cruiten/Voron-Related/README.md

# Voron-Related
Parts and documentation for personal use with my Voron 2.4r2 that are probably not ready for "prime time"...
