cruiten/Voron-Related/CANbus/Documentation/README.md

# CAN Related Installation/Configuration Documentation

Personal notes to document what I did on my Voron 2.4r2...

### Configuration and building

[Step 1. Setting up the SB2040 + CAN bus](./SB2040_CAN/install_configure_can.md)

[Step 2. The umbilical](./Umbilical/README.md)

[Step 3. Setting up the SB2040 with CAN Boot](./SB2040_CAN/install_configure_canboot.md)

&nbsp;

### Quality of life improvements:

[Flash Klipper to the Octopus and the SB2040 in one step](./SB2040_CAN/flash_klipper_script.md)

[CanBoot Deployment Application](./SB2040_CAN/canboot_deployment_application.md)
