cruiten/Voron-Related/CANbus/Umbilical/README.md

# A drive umbilical + Y endstop
## Why?
Created this to help out Discord user @DraHrEg.

I "married" hartk's "A_drive_Umbilical_PG7" and minsekt's "Y-endstop" designs.

I wish this was available when I was doing the umbilical set up for my Voron 2.4r2, because replacing the upper A drive motor plate was quite involved and required more effort than I had planned for.

The PG7 cable gland is a tight fit, so be sure to print this part using the recommend Voron print settings.

P.S. This design probably needs to be updated a bit to allow for better wire management from the switch to the area where the PG7 gland is...

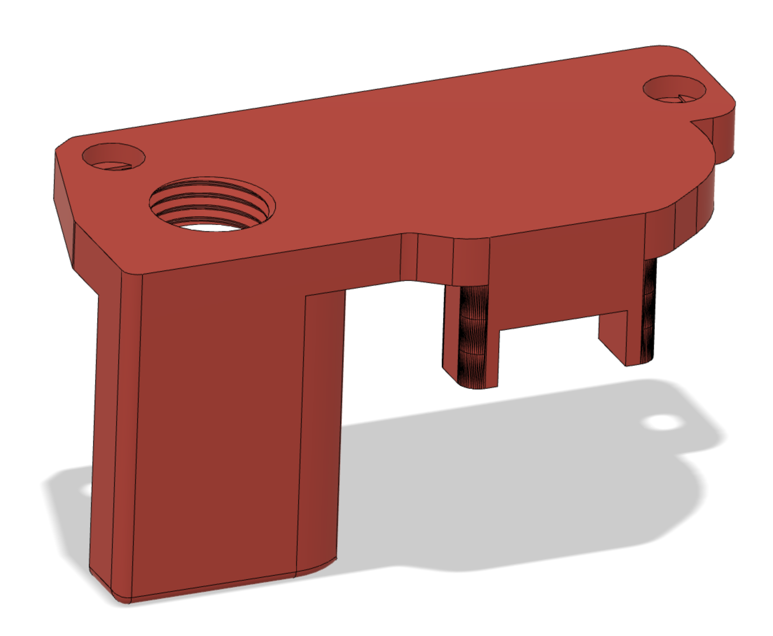
[picture p4: CANbus/Umbilical/Images/image1.png]
Front top view


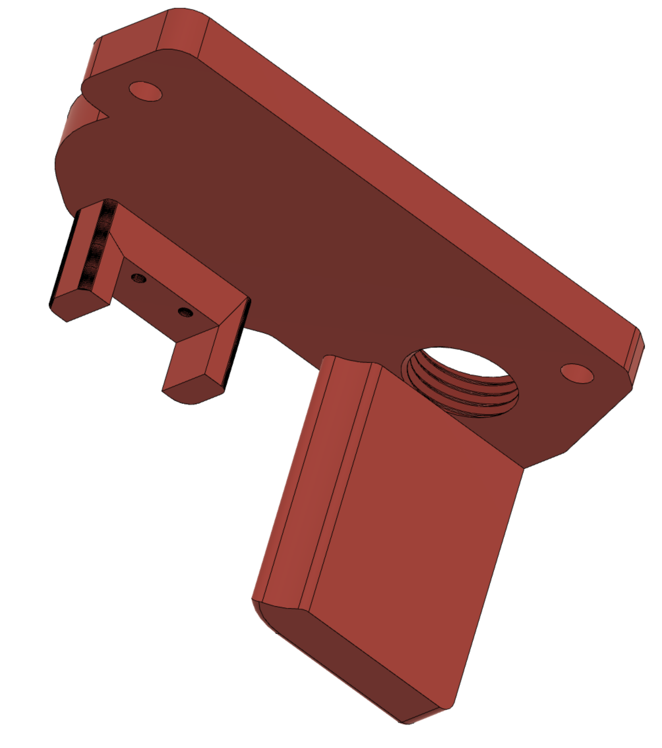
[picture p5: CANbus/Umbilical/Images/image2.png]
Bottom back view


</details>

# Umbilical mount for Clockwork 2 - Skinny Y version
## Why?
Modified hartk's version so that it would not crash into the Z-chains and the umbilical gland mounted on the A-motor plate during homing.

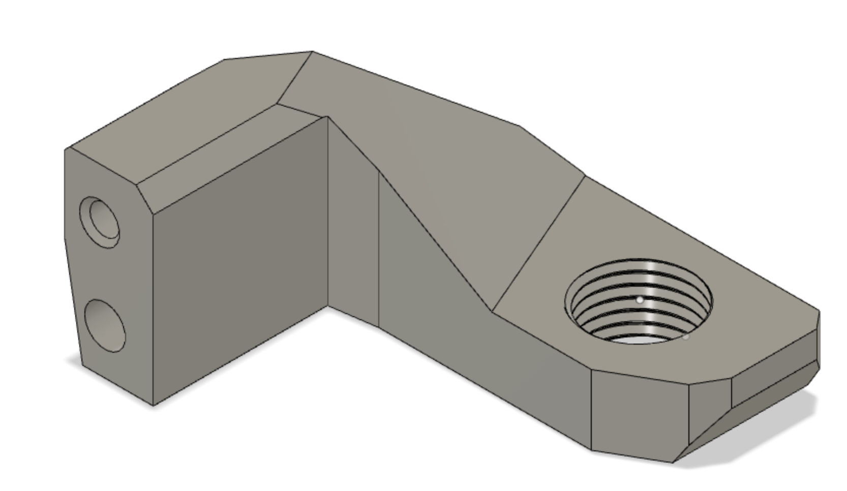
[picture p6: CANbus/Umbilical/Images/SkinnyY-side.png]
Side view


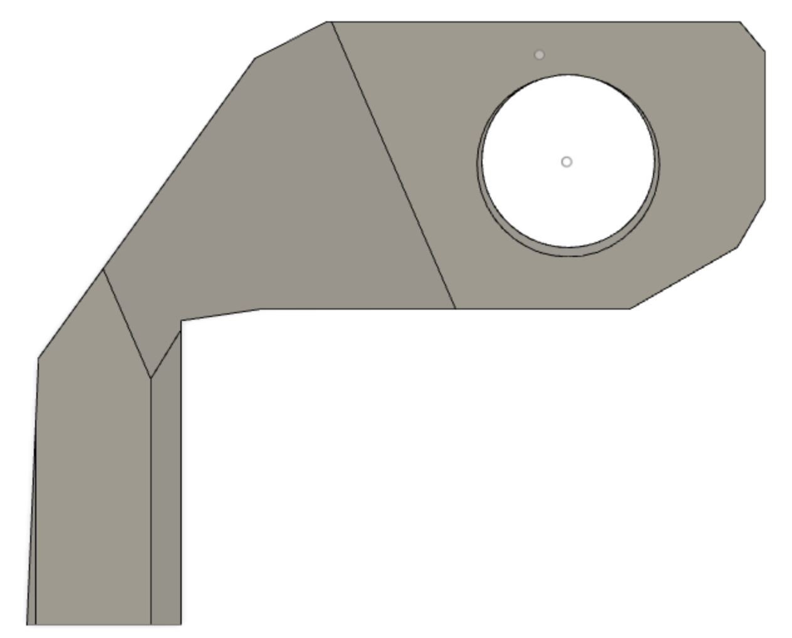
[picture p7: CANbus/Umbilical/Images/SkinnyY-top.png]


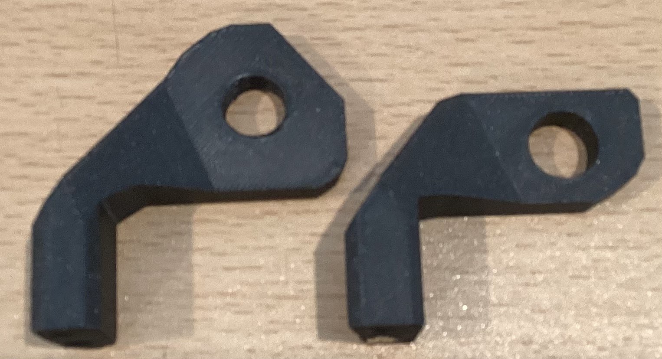
[picture p8: CANbus/Umbilical/Images/comparison.jpeg]
Comparison
