cruiten/Voron-Related/Mounts/Mellow_UTOC_fuse/README.md

# Why pay for an inline fuse holder?
If you have a couple of spare female spade connectors then there is no need to pay for an inine fuse holder for your UTOC-1 or UTOC-3. (I know that you have plenty of wire...)

This simple mount for the Mellow UTOC-1 (or UTOC-3) CAN adapter incorporates a modified version of Erik Cederberg's fuse holder that can be snapped onto the mount for the UTOC board.

## Bill Of Materials
| Item | Quantity | Notes |
| :--- | :---: | :----- |
|M3 x 8 SHCS| 4 |I mounted using only 2 screws|
|M2 x 10 SHCS| 2 |Self-tapping|
|Female Spade Connector| 2 |Terminal width: 0.25", I used non-insulated type|
|Fuse| 1 |I used 5A fuse for 24V power to CAN board|
|DIN Clip|1|https://github.com/VoronDesign/Voron-2/blob/Voron2.4/STLs/Electronics_Bay/pcb_din_clip_x3.stl|

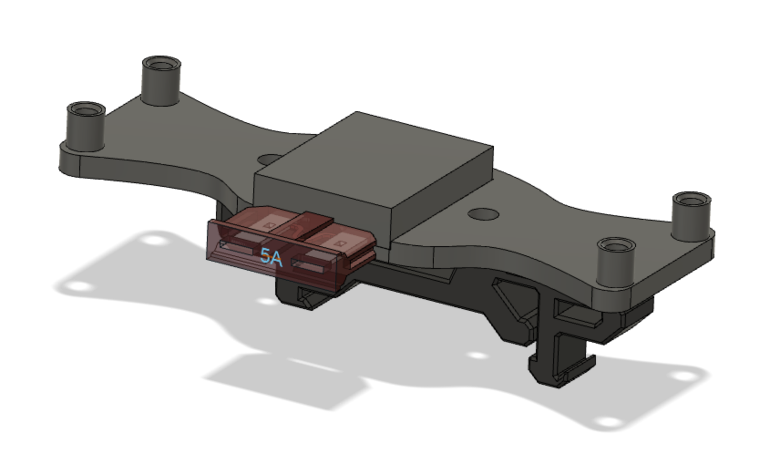
[picture p9: Mounts/Mellow_UTOC_fuse/Images/MountWithFuse.png]
Mount with fuse holder and bracket


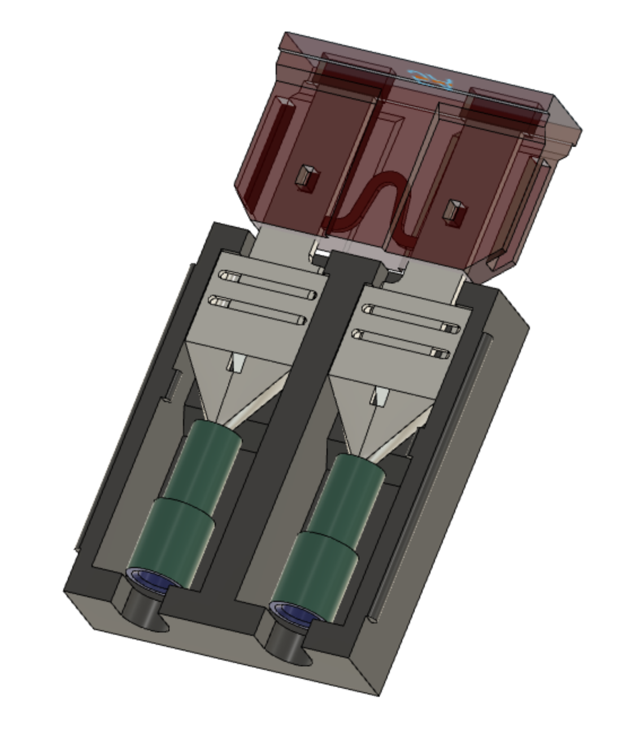
[picture p10: Mounts/Mellow_UTOC_fuse/Images/FuseHolder.png]
Fuse holder with fuse
