cruiten/Voron-Related/CANbus/Mounts/MellowFlyUTOC/README.md

# Simple mount for Mellow Fly UTOC-1/3
This mount will also work for the BTT U2C CAN transceivers.

Intended to be used with a standard Voron 2.4r2 PCB DIN clip.

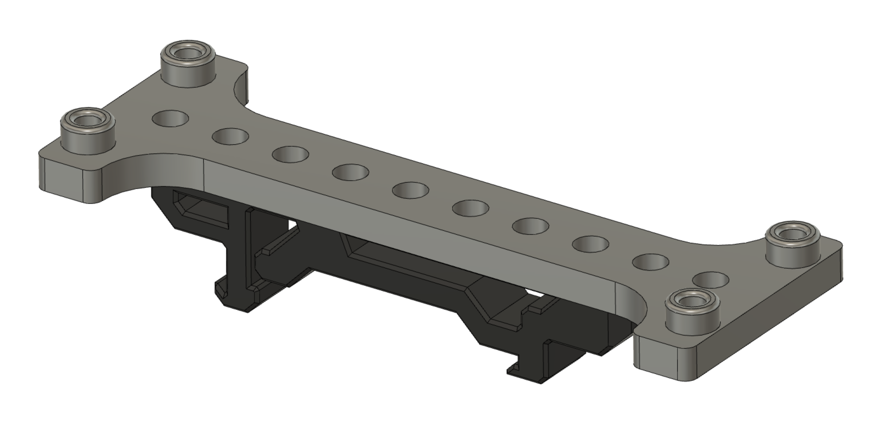
[picture p13: CANbus/Mounts/MellowFlyUTOC/Images/UTOCmount.png]
Mount
