cruiten/Voron-Related/CANbus/Mounts/MellowFlyUTOC/CAD/Fly_UTOC_Mount.step

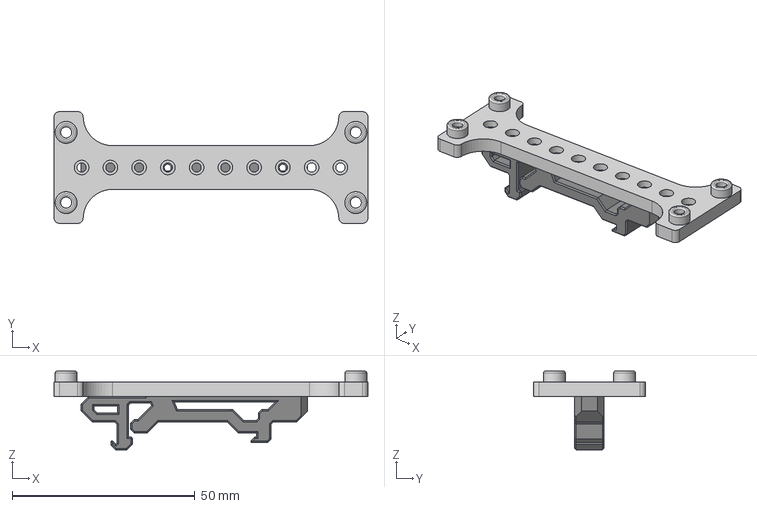
[picture p17: CAD file, 2022-10-29]
CANbus/Mounts/MellowFlyUTOC/CAD/Fly_UTOC_Mount.step
86.0 x 30.6 x 21.6 mm
