cruiten/Voron-Related/CANbus/Umbilical/CAD/cw2_umbPG7_skinnyy.step

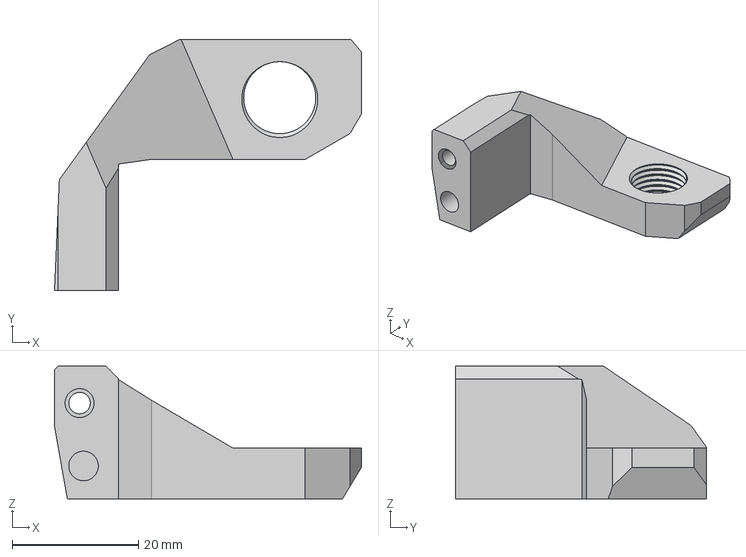
[picture p18: CAD file, 2022-10-17]
CANbus/Umbilical/CAD/cw2_umbPG7_skinnyy.step
48.7 x 39.8 x 21.1 mm
