cruiten/Voron-Related/CANbus/Umbilical/STLs/a_drive_umbilical_pg7_y_endstop.stl

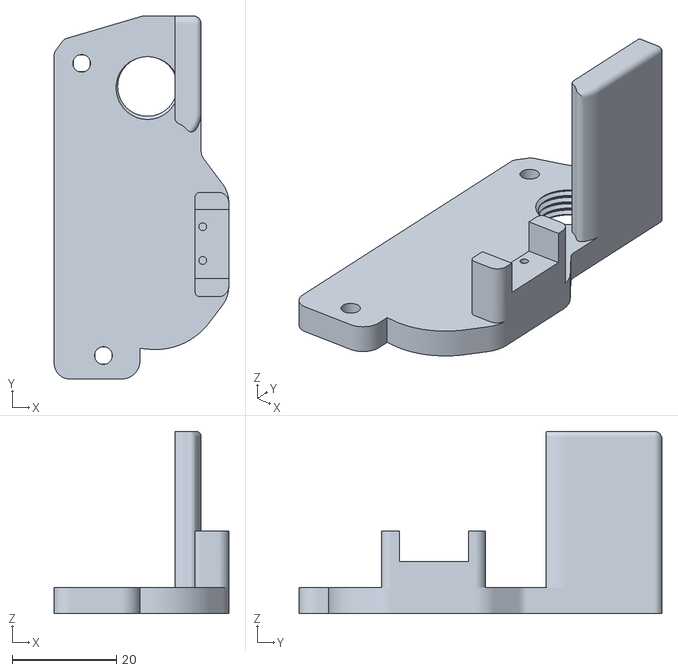
[picture p19: CAD file, 2022-10-18]
CANbus/Umbilical/STLs/a_drive_umbilical_pg7_y_endstop.stl
33.5 x 69.7 x 35.0
