cruiten/Voron-Related/FanSilencer/CAD/FanSpacer.step

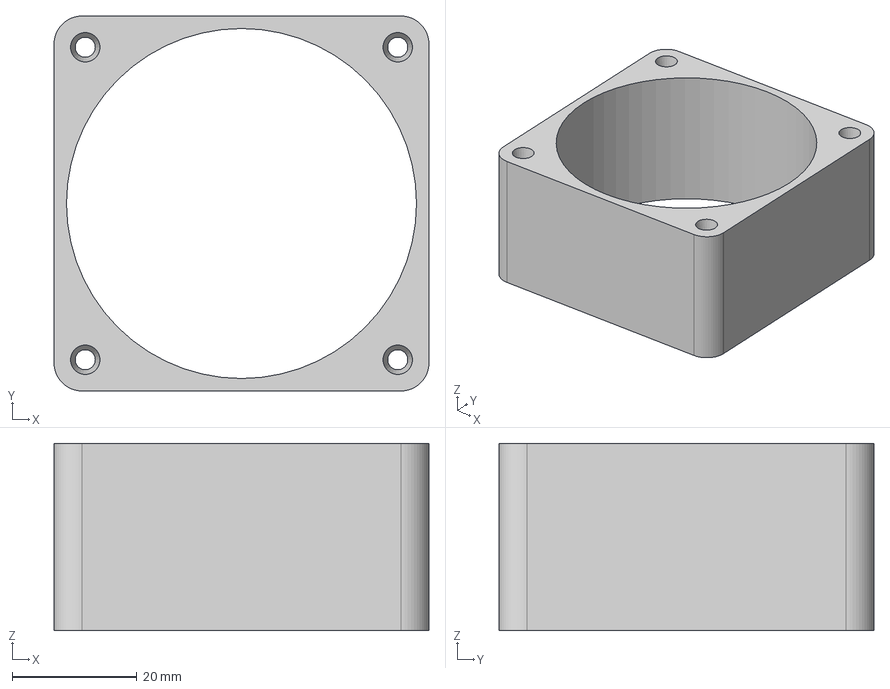
[picture p20: CAD file, 2022-10-29]
FanSilencer/CAD/FanSpacer.step
60.0 x 60.0 x 30.0 mm
