cruiten/Voron-Related/Mounts/Mellow_UTOC_fuse/STLs/UTOC_fuse_mount.stl

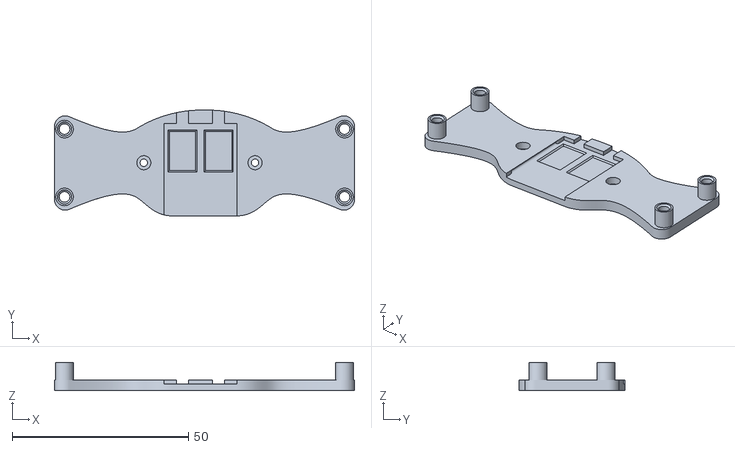
[picture p21: CAD file, 2022-10-13]
Mounts/Mellow_UTOC_fuse/STLs/UTOC_fuse_mount.stl
85.0 x 30.0 x 8.04
