cruiten/Voron-Related/SB2040FanCover/STLs/SB2040_Fan_Cover.stl

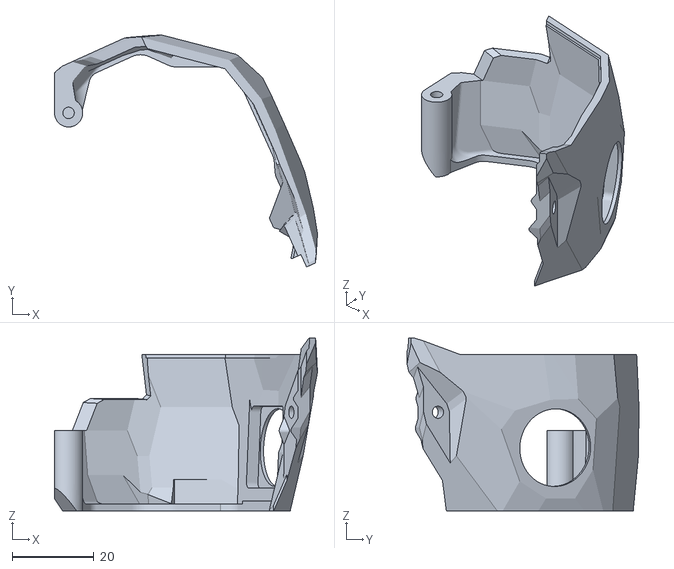
[picture p22: CAD file, 2022-12-01]
SB2040FanCover/STLs/SB2040_Fan_Cover.stl
64.3 x 56.7 x 42.2
