cruiten/Voron-Related/ZChainGuideThermistor/CAD/Z_Chain_Guide_Therm.step

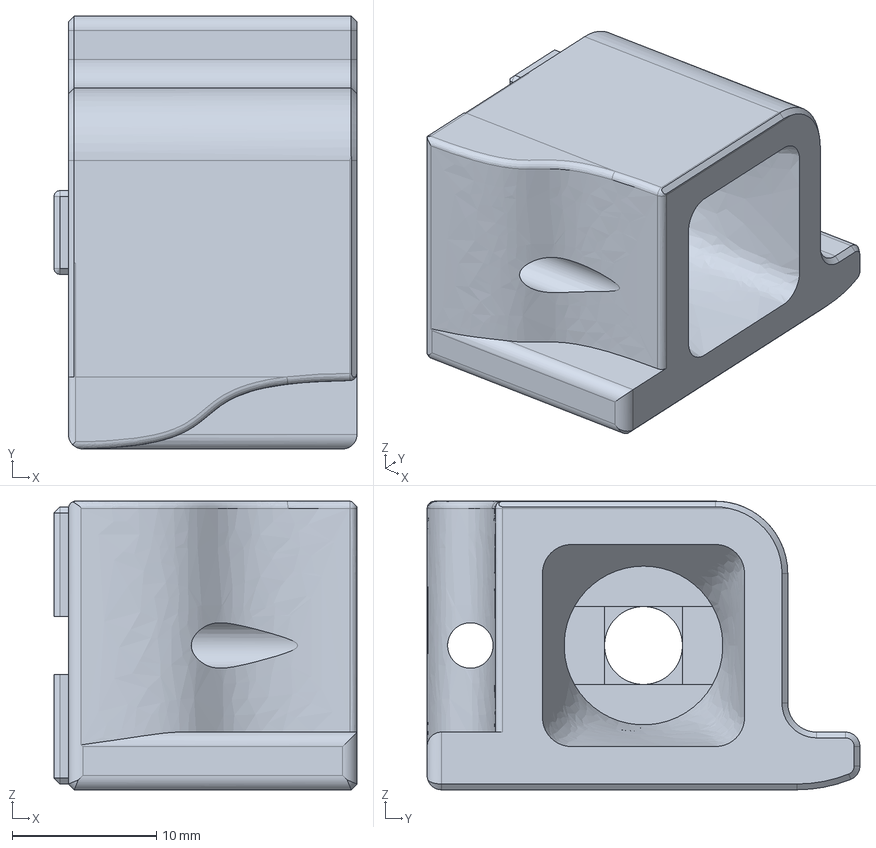
[picture p23: CAD file, 2022-10-28]
ZChainGuideThermistor/CAD/Z_Chain_Guide_Therm.step
21.0 x 30.0 x 20.0 mm
