cruiten/Voron-Related/Mounts/Mellow_UTOC_fuse/STLs/UTOC_fuseholder.stl

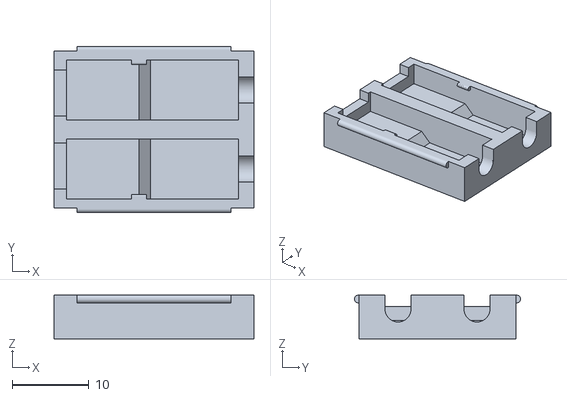
[picture p24: CAD file, 2022-10-13]
Mounts/Mellow_UTOC_fuse/STLs/UTOC_fuseholder.stl
26.1 x 21.7 x 5.70
