cruiten/Voron-Related/(list of files, cad)

Other CAD files:
FanSilencer/STLs/fan_spacer_body.stl
CANbus/Mounts/MellowFlyUTOC/STLs/FlyUTOCmount.stl
CANbus/Umbilical/STLs/cw2_umbPG7_skinnyy.stl
ZChainGuideThermistor/STLs/z_chain_guide_therm.stl
