cruiten/Voron-Related/(threads)

Thread 8 (2023-03-31):

update python can

mloebbert, 2023-03-31:
Hi cruiten,

today I updated my Voron2.4 to canbus. Thank you for the great manual.

There is a minor issue in the doku:

> NOTE: If you receive an ImportError: No module named can error, then execute the following command to install the missing module: **sudo apt install python-can**

The correct command to install the missing python package is: **pip install python-can**

BR
Markus

cruiten, 2023-04-08:
Thank you for raising this issue Markus.

The "sudo apt install python-can" command worked/works for me on my Raspberry Pi.

Is there any advantage to using the `pip install python-can` command?

I suppose that `pip` might be more system-agnostic than the `apt` command.

Please let me know.

Cor

mloebbert, 2023-04-09:
Hi Cor,

I'm wondering installing python-can using apt works for you, may you double check that.

I tried it also on my Pi:

```
pi@mainsailos:~ $ sudo apt install python-can
Reading package lists... Done
Building dependency tree... Done
Reading state information... Done
E: Unable to locate package python-can
```

Also the documentation on 'https://python-can.readthedocs.io/en/stable/installation.html' mentions the python package manager pip to install python-can.

Maybe you can add the pip call to your documentation as an alternative, if someone's system behaves like mine.

BR

Markus

cruiten, 2023-04-09:
Interesting...

I just double-checked it on my system and as you can see it does not raise any errors:

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

However, I agree that it makes sense to add the pip call as an alternative...

Cor

cruiten, 2023-04-09:
Updated documentation page with alternative way to install python-can.

Thanks you for the suggestion @mloebbert!

Cor

Closed 2023-04-09.

Thread 9 (2024-03-21):

'GPIO25' is not a valid pin name on mcu 'SB2040'

wa2mze, 2024-03-21:
I followed your instructions to set up the SB2040.  All seemed to work until I started working on the printer.cfg file.  I'm using the HV probe connector and I get the error "GPIO25 is not a valid pin name on mcu SB2040"  The line in the config file is
pin:^SB2040:GPIO25
my  klippy.log is attached.  Looks like it could be a python software error in the version of klipper I'm using.
[klippy.log](https://github.com/cruiten/Voron-Related/files/14695553/klippy.log)

cruiten, 2024-03-21:
The letters in the pin names for the SB2040 must be lower-case.

In other words, replace "GPIO25" with "gpio25" and you should be good to go.

wa2mze, 2024-03-21:
Well that got me a little further.  Now getting this error with SB2040
"MCU 'SB2040' shutdown: oids already allocated"
[klippy (1).log](https://github.com/cruiten/Voron-Related/files/14711884/klippy.1.log)

wa2mze, 2024-03-21:
Wait .... a soft reboot after updating printer.cfg didn't reset the toolhead board..  I did a power cycle, and it came up!
So, I guess there is a sw issue with the sb2040 not being able to be software reset after a config change.

Closed 2024-03-21.
