cruiten/Voron-Related/(commit log)

2022-10-13 Added STLs.
    [UTOC_fuse_mount.stl, UTOC_fuseholder.stl]
2022-10-13 Fixed orientation.
    [a_drive_umbilical_pg7_y_endstop.stl]
2022-10-17 New umbilical mount to address interference with Z-chains and umbilical mount on A-motor plate.
    [cw2_umbPG7_skinnyy.step, cw2_umbPG7_skinnyy.stl]
2022-10-17 Add images for CW2 skinny Y mount
2022-10-18 Addressed interference issues with X-axis Ti backer plate
    [a_drive_umbilical_pg7_y_endstop.stl]
2022-10-27 Archived fused mount since the fuse is not necessary...
    [UTOC_fuse_mount.stl, UTOC_fuseholder.stl]
2022-10-28 Properly grounded STL
    [Z_Chain_Guide_Therm.step, z_chain_guide_therm.stl]
2022-10-29 Initial commit for FanSilencer
    [FanSpacer.step, fan_spacer_body.stl]
2022-10-29 Initial commit of UTOC mount
    [FlyUTOCmount.stl, Fly_UTOC_Mount.step]
2022-10-29 Moved directory
    [FlyUTOCmount.stl, Fly_UTOC_Mount.step, UTOC_fuse_mount.stl, UTOC_fuseholder.stl]
2022-11-09 Added link for PTFE wires
2022-11-20 Updated CanBoot menuconfig for flashing LED
    Changed menu selections from how I did this originally so that the blue LED next to the boot button on the SB2040 will flash after a successful CanBoot flash, to distinguish from a successful Klipper flash where the blue LED remains lit.
2022-12-01 SB2040 Fan Cover
    [SB2040_Fan_Cover.stl]
